Samaksh36/OAI-33-Domino-Logic/README.md

# OAI-33-Domino-Logic
### Institute: Indraprastha Institute of Information Technology, Delhi (IIITD)
### Instructor: Dr Anuj Grover
### Course: Digital VLSI Design
### Semester: Monsoon 2021
### Abstract: Schematic and Layout implementation of a complex gate, followed by PPA analysis.

--------------------------------------------------------------------------------------------------------------

Tools: Cadence Virtuoso, Eldo, X-Circuit, WaveDrom <br /> 
<br />
Designs: OAI-33 Domino Logic Complex and its Layout | OAI-33 Logic Non Complex and its Layout <br />
<br />
Comparison Parameters: Pre Layout vs Post Layout (Parasitic Extraction Included) | Different PVT corners <br />
<br />
Figure of Merits Compared: Power | Rise/Fall Time | Delays | Area <br />
